ppppaoppp/DIY-Nitrox-Analyzer-04_12_2019/Pao Nitrox Analyzer Schematic.jpg

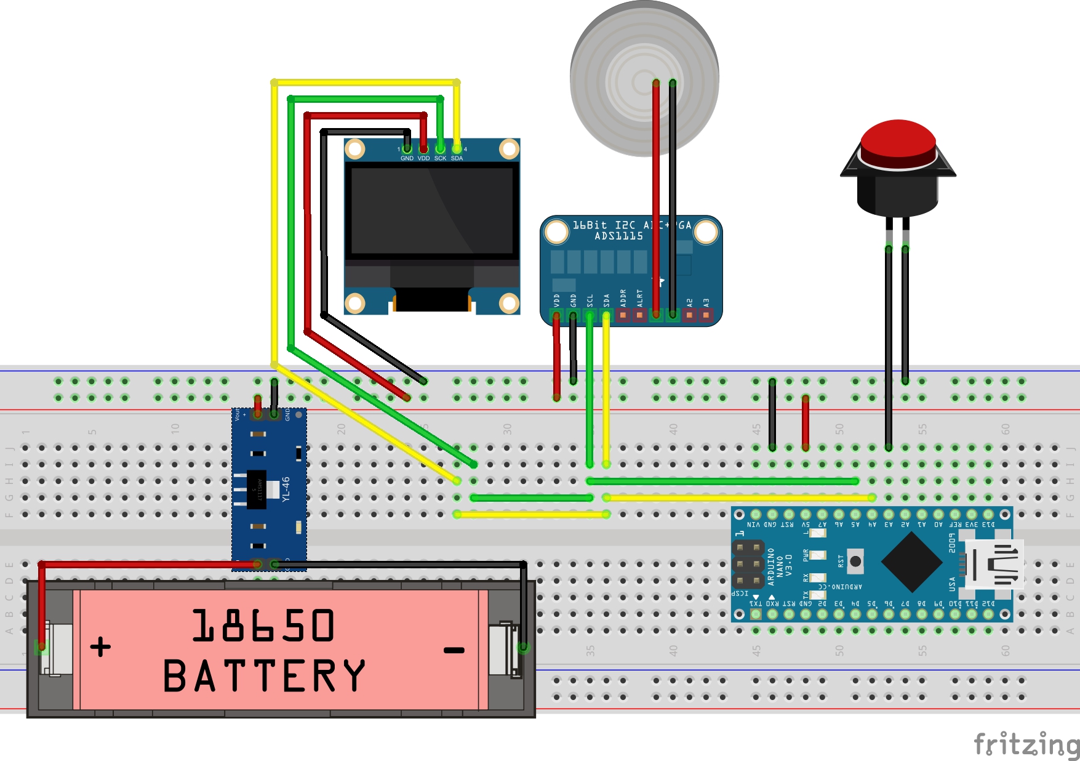
Pao Nitrox Analyzer Schematic.jpg
