ppppaoppp/DIY-Nitrox-Analyzer-04_12_2019/(notices)

Notices in the files:
O2_Analyzer_Pao_03_11_2019.ino:
This program is free software: you can redistribute it and/or modify
it under the terms of the GNU General Public License as published by
the Free Software Foundation (version 3 of the License or
any later version).
